gabrielpecoraro/Ventilator-Design-Using-a-PWM/Figure/montage PCB PWM + ventilateur.jpg

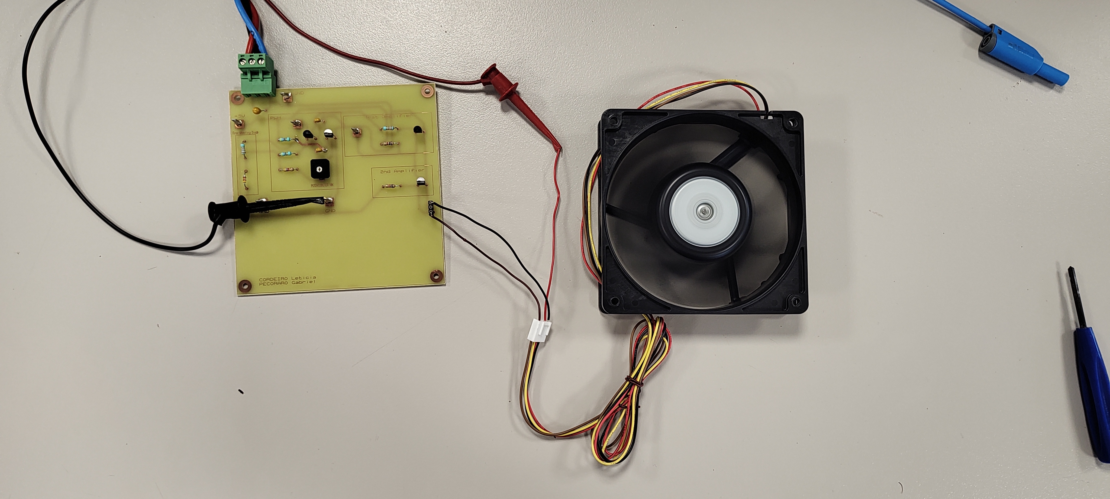
Figure/montage PCB PWM + ventilateur.jpg
