gabrielpecoraro/Ventilator-Design-Using-a-PWM/Figure/PCB bottom.jpg

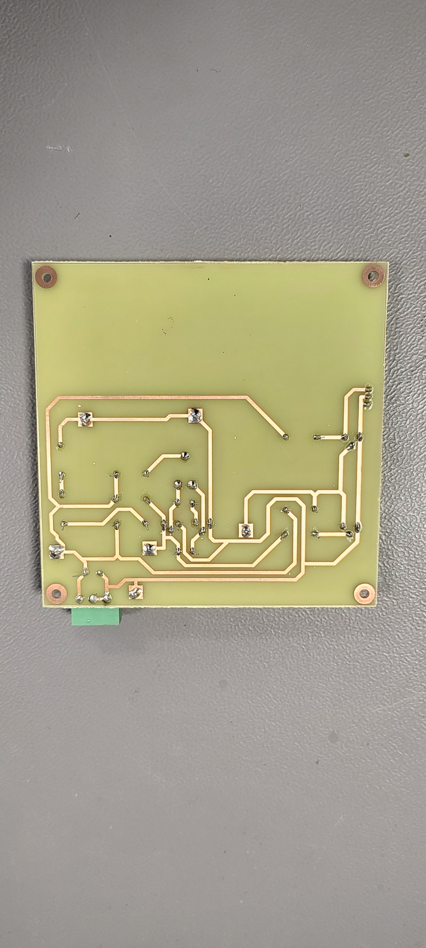
Figure/PCB bottom.jpg
