gabrielpecoraro/Ventilator-Design-Using-a-PWM/Figure/Amp2_FFT.PNG

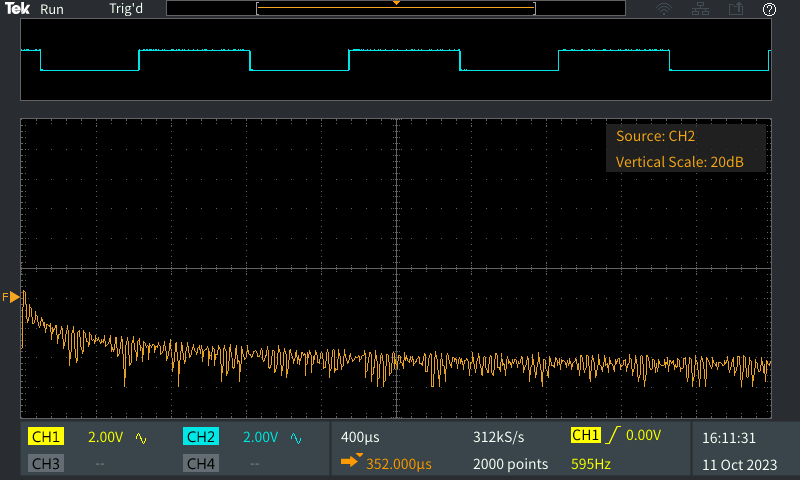
Figure/Amp2_FFT.PNG
