gabrielpecoraro/Ventilator-Design-Using-a-PWM/Figure/circuit Tachym閣re .jpg

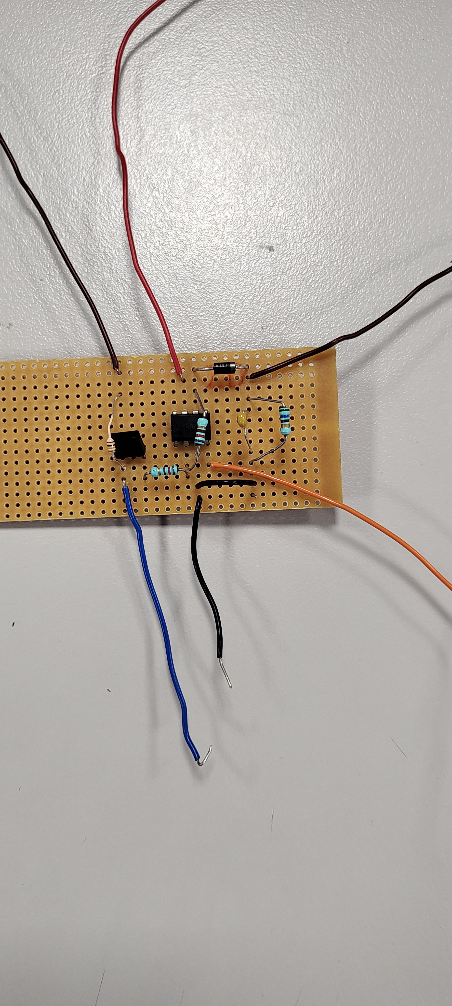
Figure/circuit Tachym閣re .jpg
