gabrielpecoraro/Ventilator-Design-Using-a-PWM/Figure/PCB top.jpg

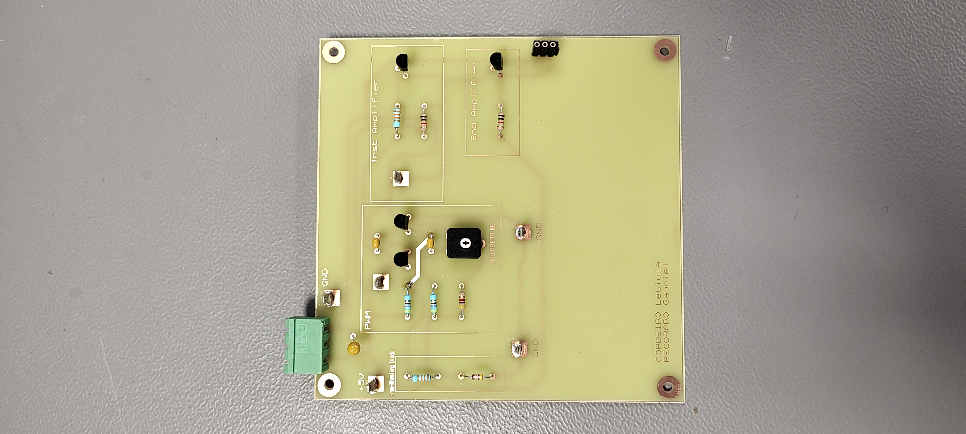
Figure/PCB top.jpg
