gabrielpecoraro/Ventilator-Design-Using-a-PWM/Figure/PCB_PWM FFT.PNG

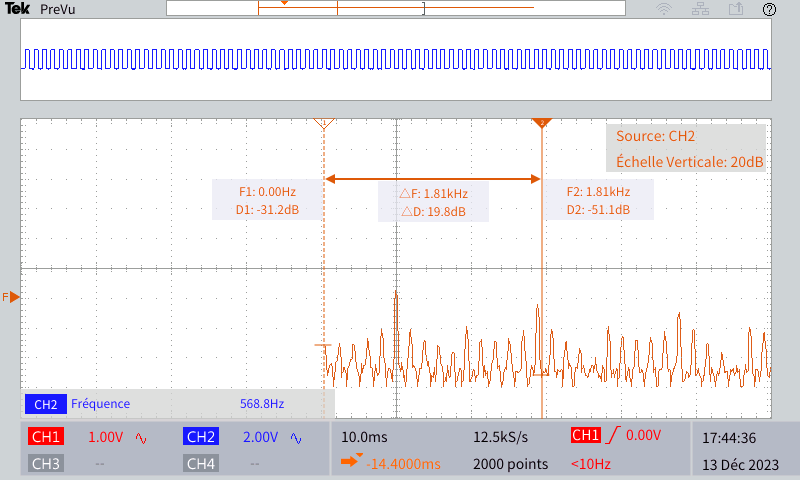
Figure/PCB_PWM FFT.PNG
