gabrielpecoraro/Ventilator-Design-Using-a-PWM/Figure/PCB_PWM primitif + finale.PNG

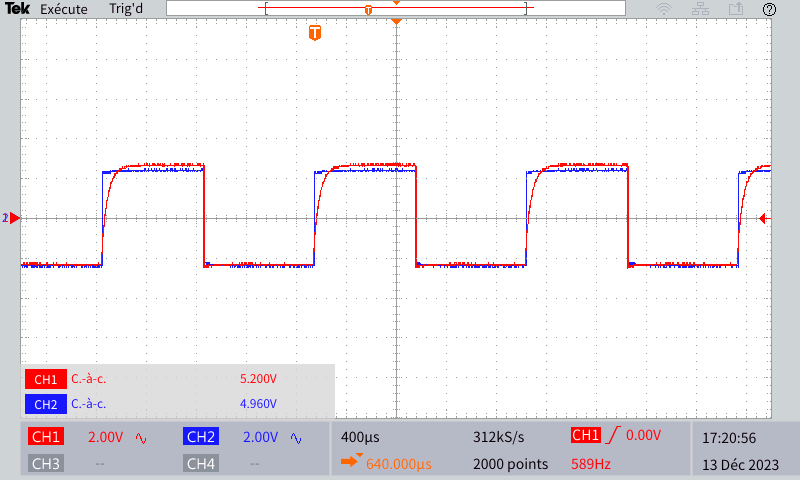
Figure/PCB_PWM primitif + finale.PNG
