gabrielpecoraro/Ventilator-Design-Using-a-PWM/Figure/PWM.PNG

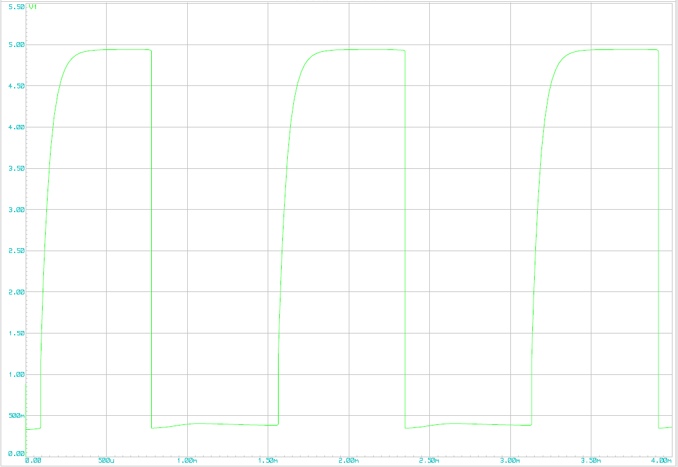
Figure/PWM.PNG
