gabrielpecoraro/Ventilator-Design-Using-a-PWM/Figure/PWM_FFT.PNG

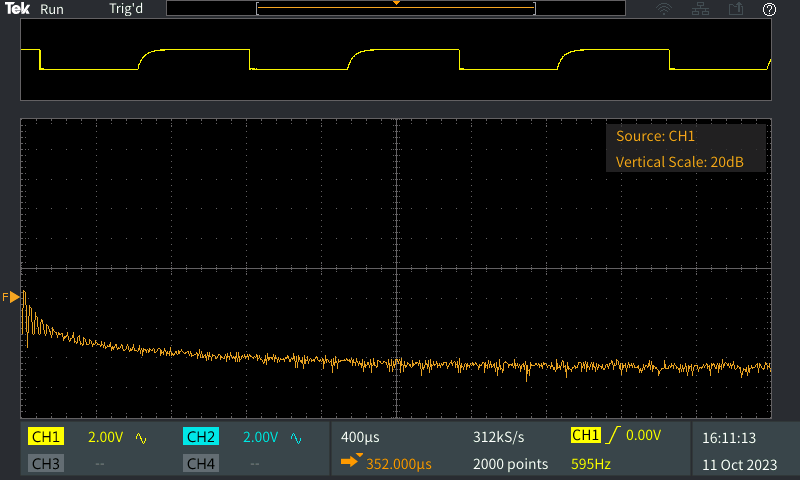
Figure/PWM_FFT.PNG
