gabrielpecoraro/Ventilator-Design-Using-a-PWM/Figure/scheme_PCB.PNG

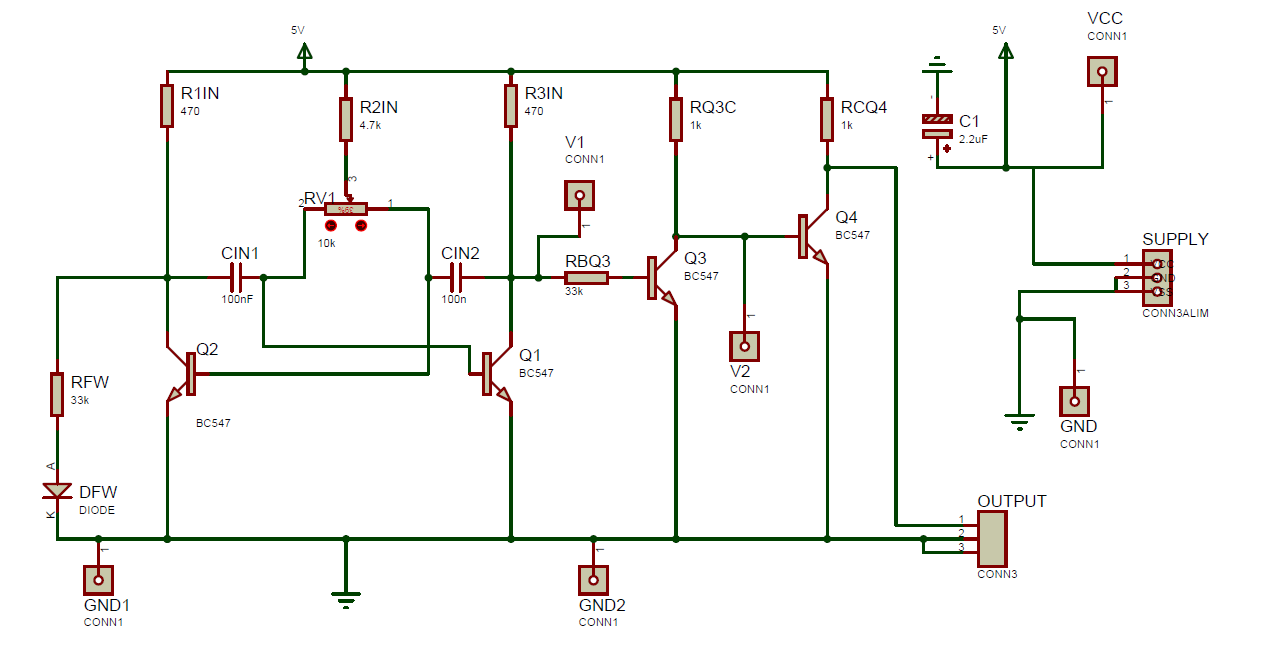
Figure/scheme_PCB.PNG
