gabrielpecoraro/Ventilator-Design-Using-a-PWM/Figure/ventilateurrr.jpg

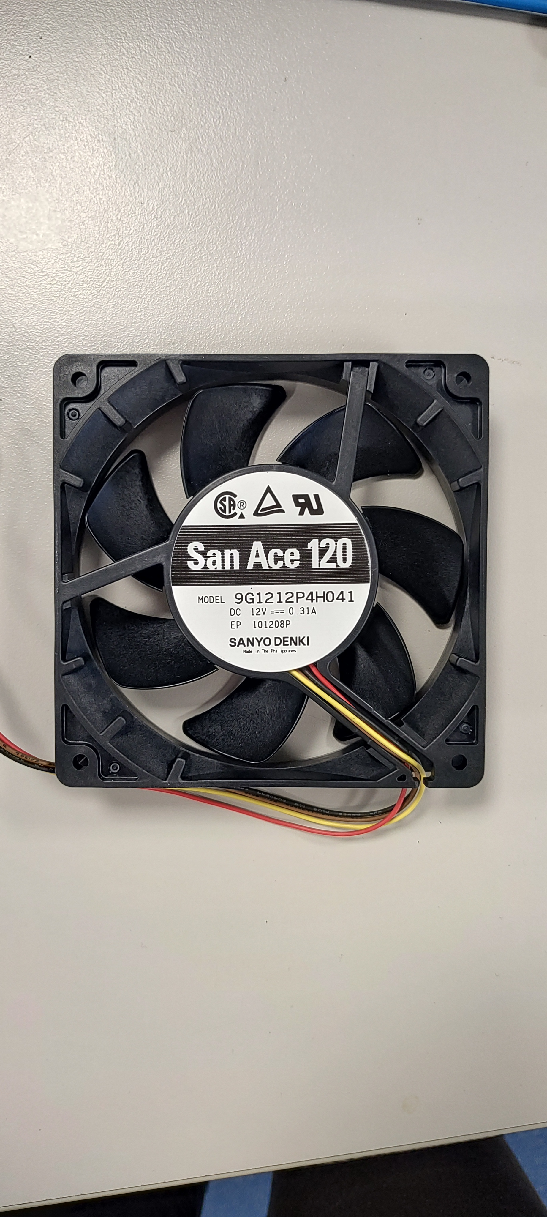
Figure/ventilateurrr.jpg
