gabrielpecoraro/Ventilator-Design-Using-a-PWM/(list of files, drawings)

Other design files:
Proteus/Analogic_1.pdsprj
Proteus/analogique_2.pdsprj
