gabrielpecoraro/Ventilator-Design-Using-a-PWM/(commit log)

2025-09-09 Rename 3PWM graphe.PNG to PWM-measure.PNG
2025-09-09 Rename 4PWM + 1 er ‚tage transistor pour carr‚ parfait.PNG to PWM+1stAmplifier.PNG
2025-09-09 Rename 5pwm + etage 1 et 2.PNG to PWMvsPWM+amp1&2.PNG
2025-09-09 Rename 6FFT pwm.PNG to PWM_FFT.PNG
2025-09-09 Rename 8PWM entier.jpg to PWM_Montage.jpg
